MSOE-Rocket-Team/2021-Avionics/README.md

# 2021-Avionics
PCB Schematic
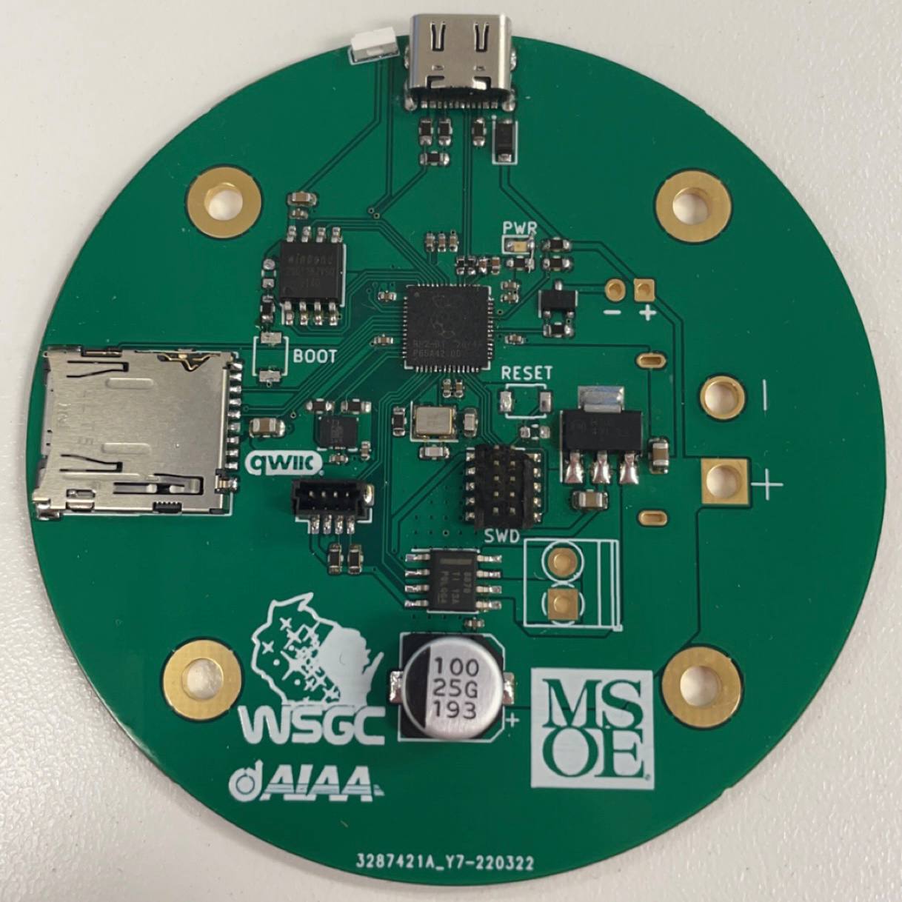
[picture p1: Media/Board.jpg]
Partially-assembled PCB
