MSOE-Rocket-Team/2021-Avionics/Hardware/Avionics.kicad_pcb

## KiCad design Hardware/Avionics.kicad_pcb (2022-04-09)

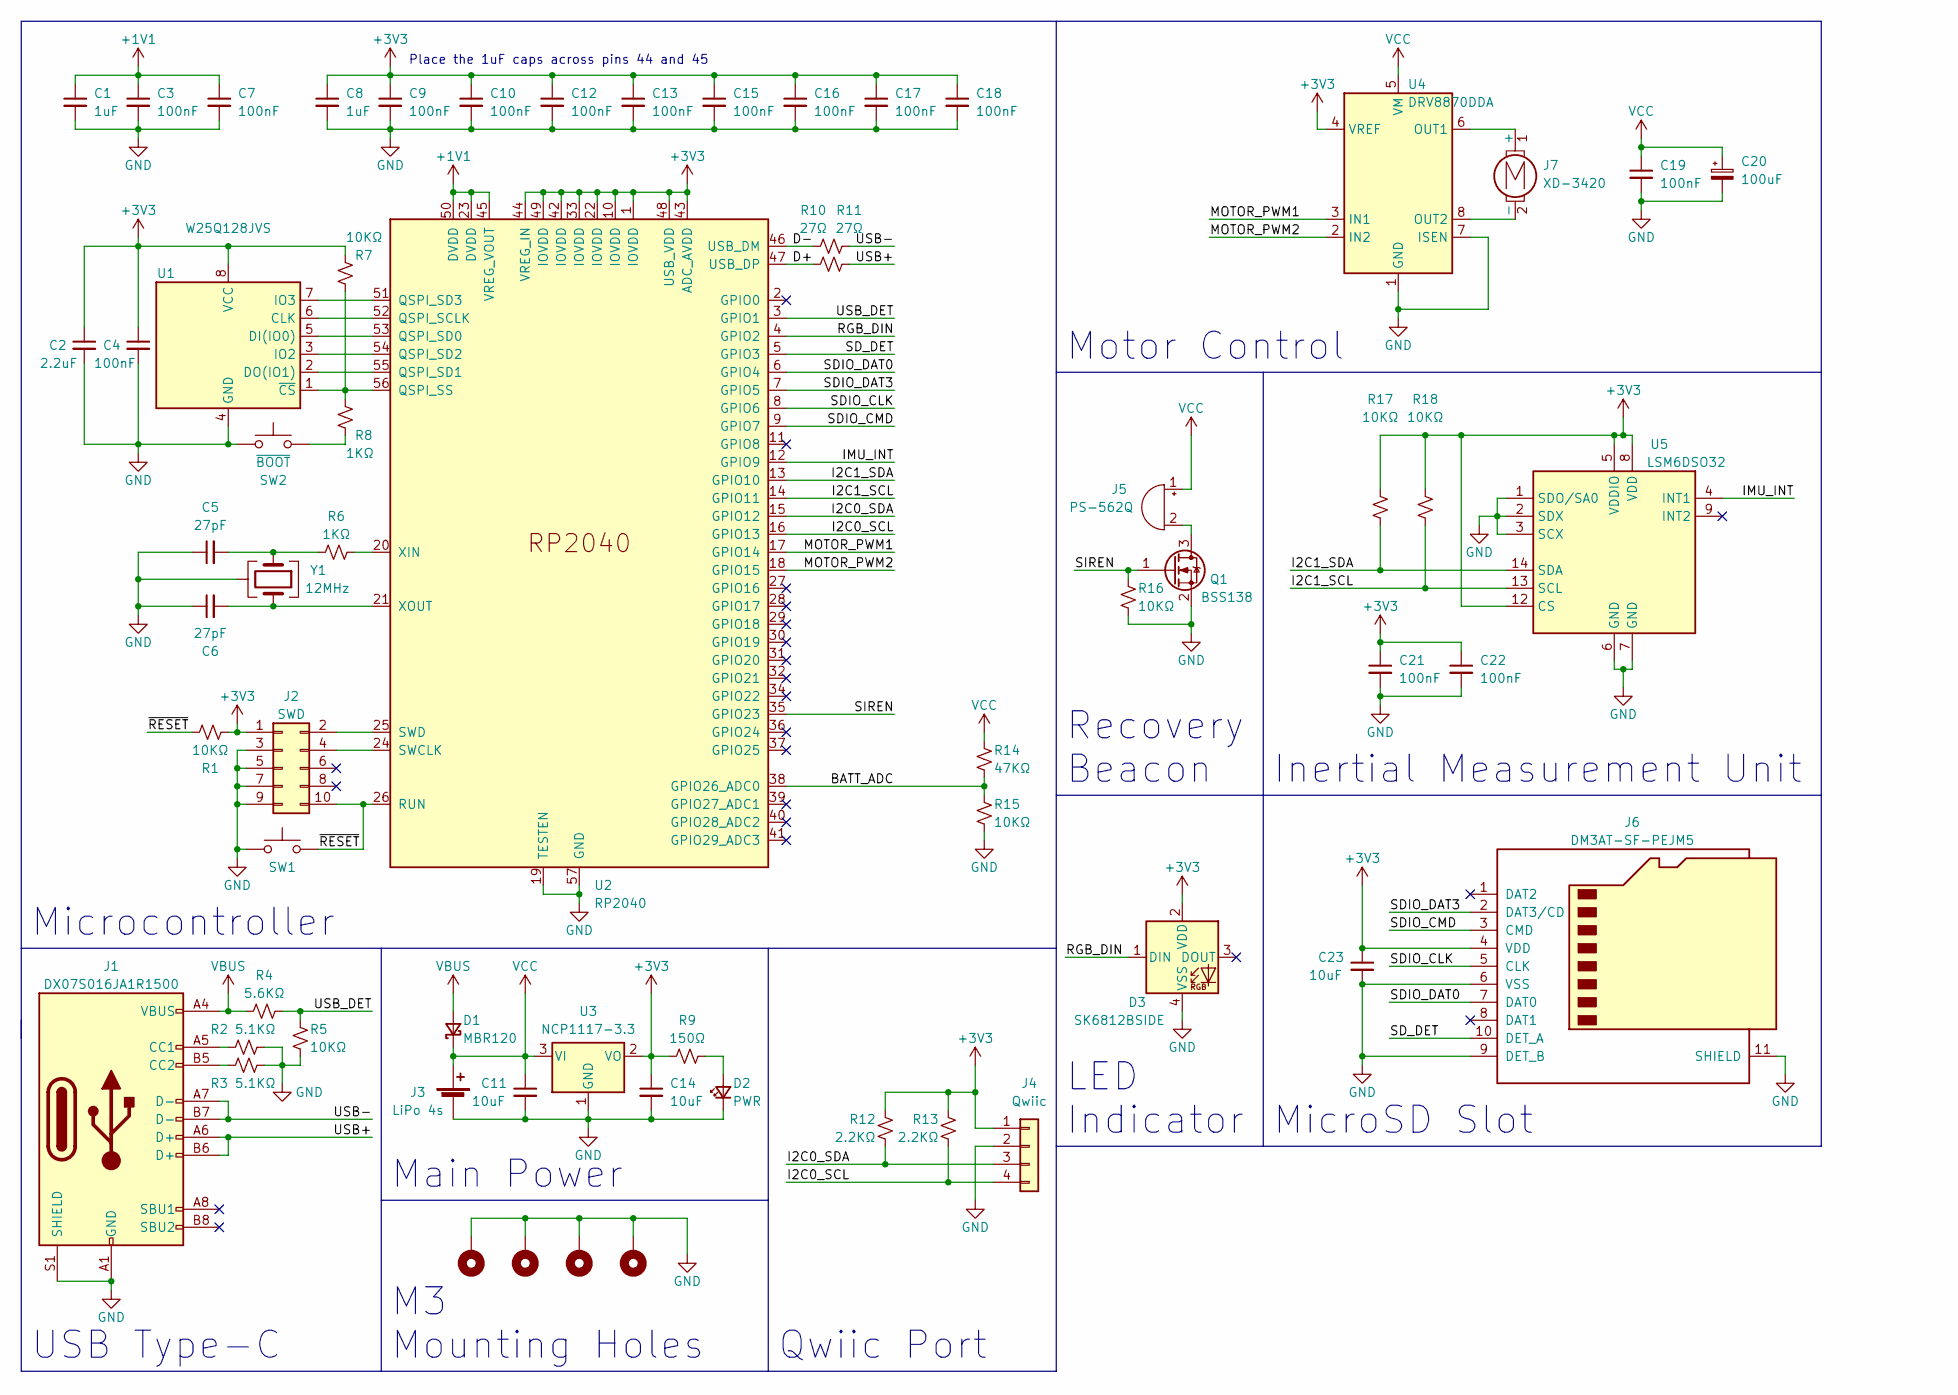
[picture p2: schematic Avionics.kicad_sch, Rocket Avionics - WSGC Collegiate Launch 2022]

Parts:
C1, C8: 1uF; C_0402_1005Metric
C2: 2.2uF; C_0603_1608Metric
C3, C4, C7, C9, C10, C12, C13, C15, C16, C17, C18, C19, C21, C22: 100nF; C_0402_1005Metric
C5, C6: 27pF; C_0603_1608Metric
C11, C14, C23: 10uF; C_0805_2012Metric
C20: 100uF; CP_Elec_8x6.5
D1: MBR120; D_SOD-123F
D2: PWR; LED_0603_1608Metric
D3: SK6812BSIDE; SK6812B_Side
H1, H2, H3, H4: M3; MountingHole_3.2mm_M3_Pad
J1: DX07S016JA1R1500
J2: SWD; PinHeader_2x05_P1.27mm_Vertical_SMD
J3: LiPo 4s; AMASS_XT60PW-M
J4: Qwiic; JST_SH_BM04B-SRSS-TB_1x04-1MP_P1.00mm_Vertical
J5: PS-562Q; JST_XH_B2B-XH-A_1x02_P2.50mm_Vertical
J6: DM3AT-SF-PEJM5; microSD_HC_Hirose_DM3AT-SF-PEJM5
J7: XD-3420; TerminalBlock_Phoenix_PT-1,5-2-3.5-H_1x02_P3.50mm_Horizontal
Q1: BSS138; SOT-23
R1, R5, R7, R15, R16, R17, R18: 10KΩ; R_0603_1608Metric
R2, R3: 5.1KΩ; R_0603_1608Metric
R4: 5.6KΩ; R_0603_1608Metric
R6, R8: 1KΩ; R_0603_1608Metric
R9: 150Ω; R_0603_1608Metric
R10, R11: 27Ω; R_0402_1005Metric
R12, R13: 2.2KΩ; R_0603_1608Metric
R14: 47KΩ; R_0603_1608Metric
SW1: ~{RESET}; SW_SPST_B3U-1000P
SW2: ~{BOOT}; SW_SPST_B3U-1000P
U1: W25Q128JVS; SOIC-8_5.23x5.23mm_P1.27mm
U2: RP2040; RP2040-QFN-56
U3: NCP1117-3.3; SOT-223-3_TabPin2
U4: DRV8870DDA; Texas_HTSOP-8-1EP_3.9x4.9mm_P1.27mm_EP2.95x4.9mm_Mask2.4x3.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
U5: LSM6DSO32; LGA-14_3x2.5mm_P0.5mm_LayoutBorder3x4y
Y1: 12MHz; Crystal_SMD_Abracon_ABM8G-4Pin_3.2x2.5mm

Connections:
+1V1: C1.1, C3.1, C7.1, U2.23 (DVDD), U2.45 (VREG_VOUT), U2.50 (DVDD)
+3V3: C2.1, C4.1, C8.1, C9.1, C10.1, C12.1, C13.1, C14.1, C15.1, C16.1, C17.1, C18.1, C21.1, C22.1, C23.1, D3.2 (VDD), J2.1, J4.1, J6.4 (VDD), R1.2, R7.1, R9.1, R12.1, R13.1, R17.1, R18.1, U1.8 (VCC), U2.1 (IOVDD), U2.10 (IOVDD), U2.22 (IOVDD), U2.33 (IOVDD), U2.42 (IOVDD), U2.43 (ADC_AVDD), U2.44 (VREG_IN), U2.48 (USB_VDD), U2.49 (IOVDD), U3.2 (VO), U4.4 (VREF), U5.5 (VDDIO), U5.8 (VDD), U5.12 (CS)
/BATT_ADC: R14.2, R15.1, U2.38 (GPIO26_ADC0)
/D+: R11.1, U2.47 (USB_DP)
/D-: R10.1, U2.46 (USB_DM)
/I2C0_SCL: J4.4, R13.2, U2.16 (GPIO13)
/I2C0_SDA: J4.3, R12.2, U2.15 (GPIO12)
/I2C1_SCL: R18.2, U2.14 (GPIO11), U5.13 (SCL)
/I2C1_SDA: R17.2, U2.13 (GPIO10), U5.14 (SDA)
/IMU_INT: U2.12 (GPIO9), U5.4 (INT1)
/MOTOR_PWM1: U2.17 (GPIO14), U4.3 (IN1)
/MOTOR_PWM2: U2.18 (GPIO15), U4.2 (IN2)
/RGB_DIN: D3.1 (DIN), U2.4 (GPIO2)
/SDIO_CLK: J6.5 (CLK), U2.8 (GPIO6)
/SDIO_CMD: J6.3 (CMD), U2.9 (GPIO7)
/SDIO_DAT0: J6.7 (DAT0), U2.6 (GPIO4)
/SDIO_DAT3: J6.2 (DAT3/CD), U2.7 (GPIO5)
/SD_DET: J6.10 (DET_A), U2.5 (GPIO3)
/SIREN: Q1.1 (G), R16.1, U2.35 (GPIO23)
/USB+: J1.A6 (D+), J1.B6 (D+), R11.2
/USB-: J1.A7 (D-), J1.B7 (D-), R10.2
/USB_DET: R4.2, R5.1, U2.3 (GPIO1)
/~RESET: J2.10, R1.1, SW1.2, U2.26 (RUN)
GND: C1.2, C2.2, C3.2, C4.2, C5.1, C6.1, C7.2, C8.2, C9.2, C10.2, C11.2, C12.2, C13.2, C14.2, C15.2, C16.2, C17.2, C18.2, C19.2, C20.2, C21.2, C22.2, C23.2, D2.1 (K), D3.4 (VSS), H1.1, H2.1, H3.1, H4.1, J1.A1 (GND), J1.A12 (GND), J1.B1 (GND), J1.B12 (GND), J1.S1 (SHIELD), J2.3, J2.5, J2.7, J2.9, J3.2 (-), J4.2, J6.6 (VSS), J6.9 (DET_B), J6.11 (SHIELD), Q1.2 (S), R2.2, R3.2, R5.2, R15.2, R16.2, SW1.1, SW2.1, U1.4 (GND), U2.19 (TESTEN), U2.57 (GND), U3.1 (GND), U4.1 (GND), U4.7 (ISEN), U4.9 (GND), U5.1 (SDO/SA0), U5.2 (SDX), U5.3 (SCX), U5.6 (GND), U5.7 (GND), Y1.2, Y1.4
unnamed: C5.2, R6.1, Y1.1
unnamed: C6.2, U2.21 (XOUT), Y1.3
unnamed: D2.2 (A), R9.2
unnamed: J1.A5 (CC1), R2.1
unnamed: J1.B5 (CC2), R3.1
unnamed: J2.2, U2.25 (SWD)
unnamed: J2.4, U2.24 (SWCLK)
unnamed: J5.2 (+), Q1.3 (D)
unnamed: J7.1 (+), U4.6 (OUT1)
unnamed: J7.2 (-), U4.8 (OUT2)
unnamed: R6.2, U2.20 (XIN)
unnamed: R7.2, R8.1, U1.1 (~CS), U2.56 (QSPI_SS)
unnamed: R8.2, SW2.2
unnamed: U1.2 (DO(IO1)), U2.55 (QSPI_SD1)
unnamed: U1.3 (IO2), U2.54 (QSPI_SD2)
unnamed: U1.5 (DI(IO0)), U2.53 (QSPI_SD0)
unnamed: U1.6 (CLK), U2.52 (QSPI_SCLK)
unnamed: U1.7 (IO3), U2.51 (QSPI_SD3)
VBUS: D1.2 (A), J1.A4 (VBUS), J1.A9 (VBUS), J1.B4 (VBUS), J1.B9 (VBUS), R4.1
VCC: C11.1, C19.1, C20.1, D1.1 (K), J3.1 (+), J5.1 (-), R14.1, U3.3 (VI), U4.5 (VM)

Notes on the sheet:
Place the 1uF caps across pins 44 and 45
Recovery Beacon
LED Indicator
Microcontroller
M3 Mounting Holes
Inertial Measurement Unit
MicroSD Slot
Main Power
USB Type-C
Qwiic Port
Motor Control

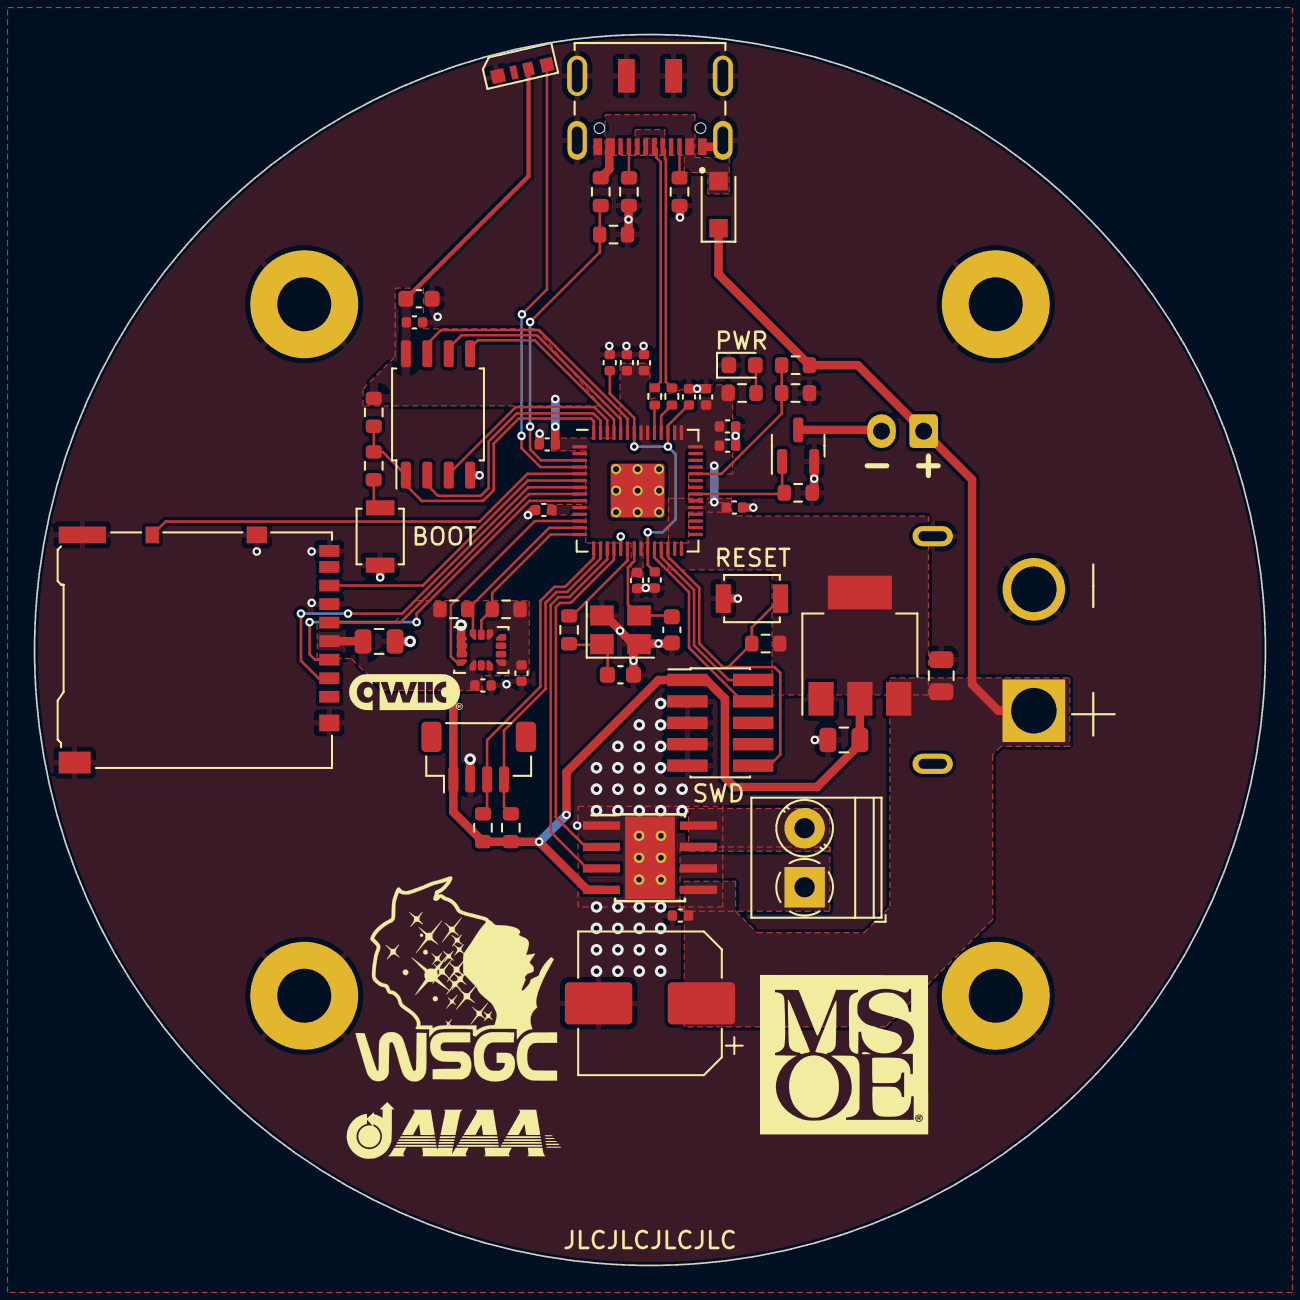
[picture p3: board Avionics.kicad_pcb from above]

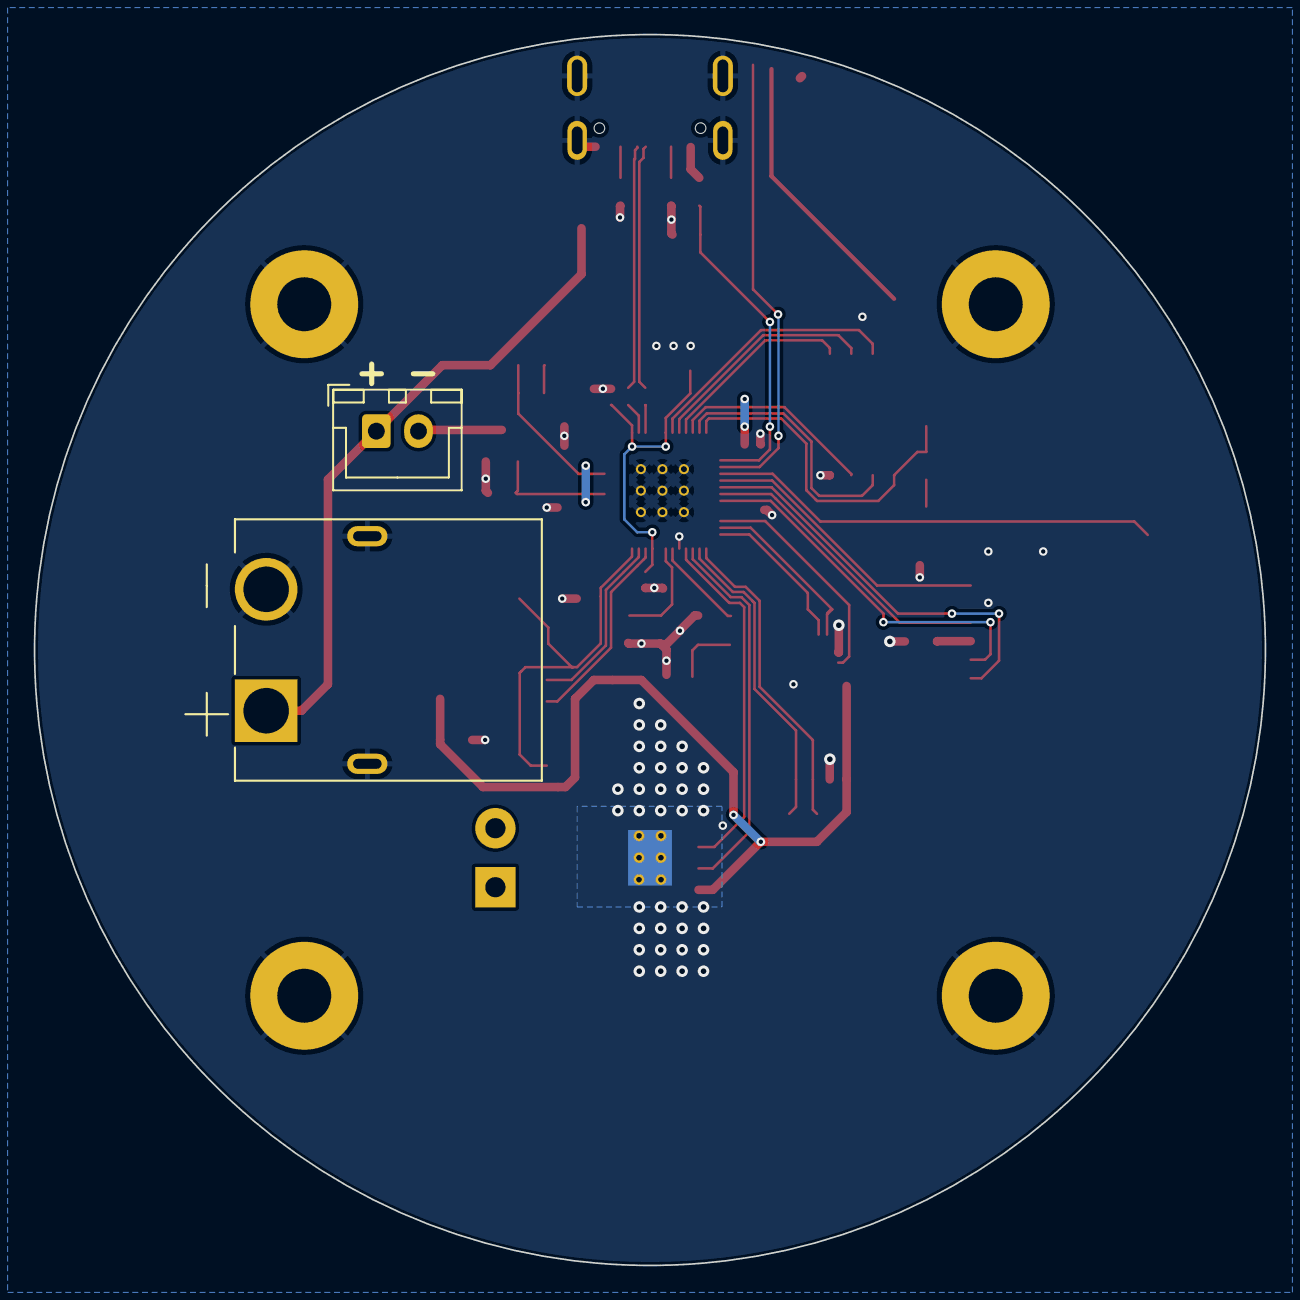
[picture p4: board Avionics.kicad_pcb from below]

Board: 2 copper layers, 73.0 x 73.0 mm, 64 parts (2 on the bottom side), 44 nets.
