MSOE-Rocket-Team/2021-Avionics/(commit log)

2021-11-29 Created directory structure and initial KiCAD project
    [Avionics.kicad_pcb, Avionics.sch]
2021-11-29 Fixed directories and added initial Arduino sketch
2021-11-29 Fixed Arduino project
2021-12-30 Updated project files to KiCAD 6.0 release
    [Avionics.kicad_pcb, Avionics.kicad_sch, Avionics.sch]
2022-01-08 Added most parts to schematic and created library part for RP2040
    [Avionics.kicad_pcb, Avionics.kicad_sch]
2022-01-08 Add L298P driver
    [Avionics.kicad_sch]
2022-02-24 Layout complete, pending review
    [Avionics.kicad_pcb, Avionics.kicad_sch]
2022-02-24 Fixed part libraries
    [Avionics.kicad_pcb]
2022-03-15 Modified layout
    [Avionics.kicad_pcb, Avionics.kicad_sch]
2022-03-16 Moved reference designators to fab layer
    [Avionics.kicad_pcb, Avionics.kicad_sch]
2022-03-18 Added silkscreen logos and improved power routing
    [Avionics.kicad_pcb]
2022-03-25 Add PID
2022-03-27 Rename pid and enable serial
2022-03-28 Add motor control
2022-03-30 Add IMU
2022-04-07 Final layout
    [Avionics.kicad_pcb]
2022-04-26 Try to fix sd card
    [diskio.c, imu.c, log.c, main.c]
